diloon0/caldera-keyboard/cirrus-pcb/jlcpcb/cirrus_left_bom.csv

Comment | Designator | Footprint | JLCPCB Part #
EVQPUC02K reset button | B1 | Panasonic_EVQPUL_EVQPUC | C79174
100nF | C1 | C_0402_1005Metric | C1525
1N4148W | D1,D2,D3,D4,D5,D6,D7,D8,D9,D10,D11,D12,D13,D14,D15,D16,D17,D18,D19,D20,D21,D22,D23,D24,D25,D26,D27,D28,D29,D30 | D_SOD-123 | C81598
SK6812SIDE-A-RVS | LED1 | SK6812SIDE-A-RVS | C2890037
DMG1013UW | Q1 | SOT-323_SC-70 | C3040603
2N7002WT1G | Q2 | SOT-323_SC-70 | C232391
100k | R1,R2 | R_0402_1005Metric | C25741
K3-1296S-E1 power slide switch | T1 | SW_SPDT_Shouhan_MSK12C02 | C128955
