diloon0/caldera-keyboard/(commit log)

2026-11-06 Clean up config and add ZMK Studio support
    - Pin ZMK to v0.3 (west.yml + workflow) so builds stop tracking main
    - Remove duplicate shield keymap; config/caldera.keymap is the only one
    - Merge left/right .conf into caldera.conf (resolves FULL vs BASIC consumer usages)
    - Fix matrix transform: drop phantom 6th row (now 5x12 = 60 keys)
    - Add physical layout (caldera-layouts.dtsi) and enable Studio on left half
    - Keymap: named layer defines, display-names, drop deprecated labels,
    replace unused empty layers with Studio-reserved layers (no key changes)
    - Fix right-side column numbers in caldera.json
    - Add fork notes, flashing/Studio steps, and pin table to README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
2026-11-06 Numpad redesign, word-delete mode, 1h sleep, system layer
    - Left-thumb key: hold = Numpad, tap = Layer Lock
    - Numpad: 0 under 1, Tab beside 4, comma replaces duplicate minus,
    non-numpad keys moved out; Backspace always single-character
    - Word-delete mode (Layer Lock + Backspace): Ctrl+Bksp / Ctrl+Del,
    including Nav's Delete via a conditional layer
    - Shift+Backspace sends Delete
    - "Go home" turns off locked layers but keeps word-delete mode
    - Bluetooth layer becomes System: output USB/BLE, bootloader on each half,
    Studio unlock and sleep keys moved here
    - Nav: Caps Word, F11, prev/next track, Print Screen, Scroll Lock
    - Deep sleep after 1 hour (was 15 min default)
    - README: new flashing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
2026-11-06 README: step-by-step flashing without the reset button
2026-11-06 Fix settings file location so ZMK actually loads it
    caldera.conf was in boards/shields/caldera/, where ZMK never reads it.
    That left mouse scrolling, deep sleep, the 1h timeout, TX power and full
    consumer keys disabled. ZMK reads config/<shield folder>.conf.
2026-11-10 Layer Lock/System fixes, BT 1/2 toggle, formatting keys, Nav Backspace
    - Layer Lock actions now end Layer Lock immediately (a sticky layer only
    ends on a typed character, so toggles left it active for ~1 s)
    - System layer is one-shot: each action closes it; 5 s timeout
    - Remove "forget all devices" from System
    - New custom behavior (src/behaviors): toggle Bluetooth profiles 0/1,
    on Layer Lock + Tab
    - Numpad left home row: Ctrl+B / Ctrl+I / Ctrl+U
    - Nav: restore Backspace (Ctrl+Backspace with Nav's Ctrl); F11 moves to Esc spot
2026-11-10 Rename keyboard to Cirrus; add Cirrus left PCB with status LED
    Firmware
    - Shield renamed caldera -> cirrus (cirrus_left / cirrus_right); files moved to
    config/boards/shields/cirrus and config/cirrus.{keymap,conf,json}
    - Bluetooth/USB name is now "Cirrus"; Studio layout renamed
    - Build artifact for the left half is cirrus_left_studio.uf2
    PCB (cirrus-pcb/)
    - Cirrus left board: the original Caldera left board plus a side-emitting
    SK6812SIDE-A-RVS status LED on the inner edge, with a P/N-MOSFET switch
    (DMG1013UW + 2N7002WT1G, 2x 100k, 100nF) so firmware can power it off.
    LED data on P0.06, power enable on P0.08. Passes KiCad DRC.
    - Board text now reads "Cirrus"
    - Custom LED footprint, r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
    [cirrus_left.kicad_pcb, left_v1_kicad10.kicad_pcb]
2026-11-10 Cirrus left PCB: JLCPCB order files (gerbers, BOM, placement)
    - scripts/make_jlcpcb_files.py builds jlcpcb/: gerber+drill zip, BOM with
    JLCPCB part numbers, and placement (CPL) file for the 38 assembled parts
    - Original Ergogen parts are marked front-side but have back-side pads;
    scripts/match_parts.py swaps in matching standard KiCad footprints (exact
    pad match for diodes and reset button, 0.07 mm for the power switch) so
    every assembled part is placed on the bottom with standard rotations
    - README: ordering steps and what to check in JLCPCB's placement preview
    [cirrus_left-B_Cu.gbl, cirrus_left-B_Mask.gbs, cirrus_left-B_Paste.gbp, cirrus_left-B_Silkscreen.gbo, cirrus_left-Edge_Cuts.gm1, cirrus_left-F_Cu.gtl, cirrus_left-F_Mask.gts, cirrus_left-F_Paste.gtp]
2026-11-11 Status light firmware for the Cirrus left PCB
    Drives the SK6812 side LED (data P0.06, power enable P0.08):
    - signals, queued so they never cut each other off: Bluetooth profile
    blinks, power-on battery check, low-battery reminders every 30 s
    (left half 1 blink, right half 2 fast blinks)
    - then layer colors (Layer Lock, System, Nav, Numpad, ...), then Caps
    Lock, then word-delete mode
    - LED power switched off when there's nothing to show, when idle and
    before deep sleep
    Enables HID indicators (needs a one-time Bluetooth re-pair) and
    right-half battery fetching on the left half.
